lexvyshnevskyy/crsf-bridge/docs/tx12-16-contact_holder.SLDPRT

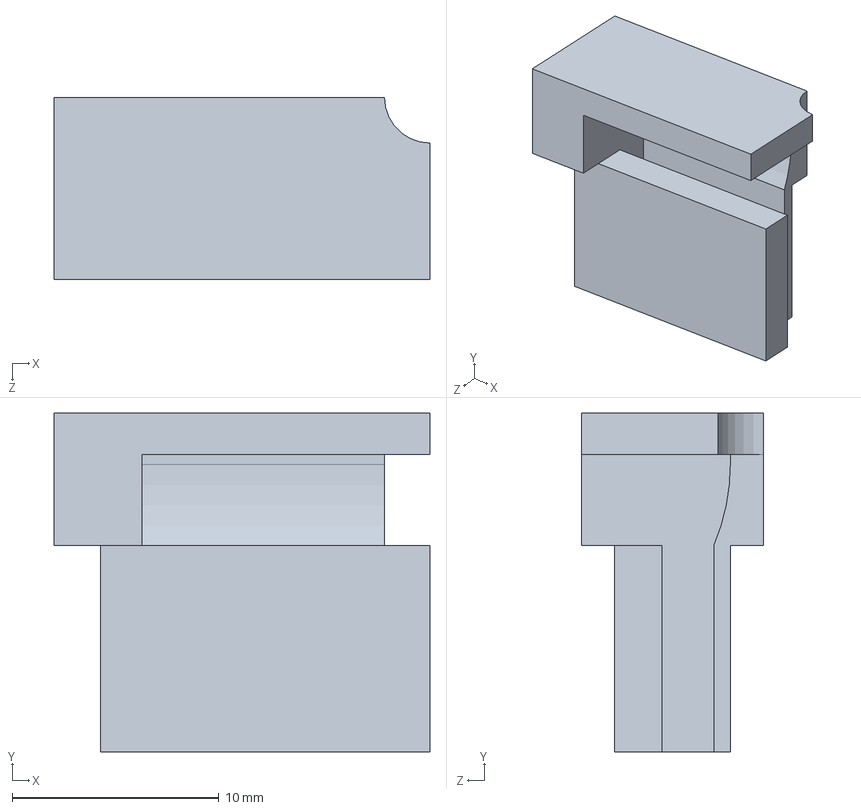
[picture p7: CAD file, 2026-11-03]
docs/tx12-16-contact_holder.SLDPRT
18.2 x 16.4 x 8.80 mm
