lexvyshnevskyy/crsf-bridge/docs/tx12-16_ethernet.SLDPRT

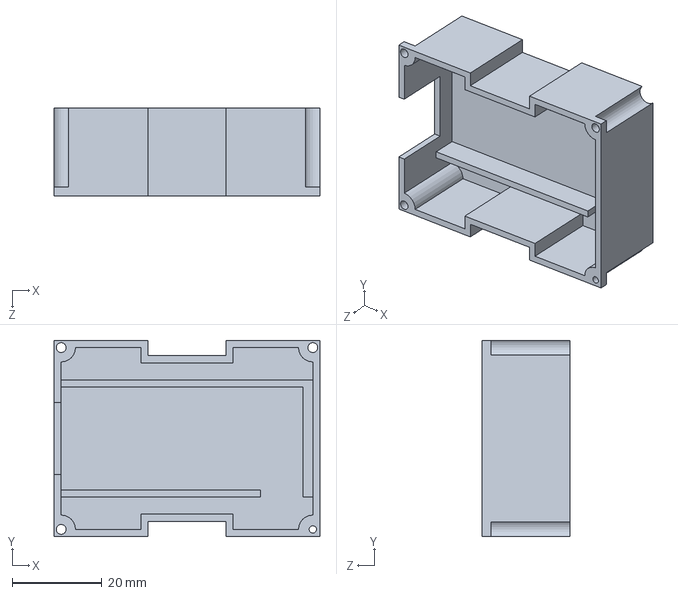
[picture p8: CAD file, 2026-11-03]
docs/tx12-16_ethernet.SLDPRT
59.4 x 43.8 x 19.6 mm
