lexvyshnevskyy/crsf-bridge/docs/tx12-16_module.SLDPRT

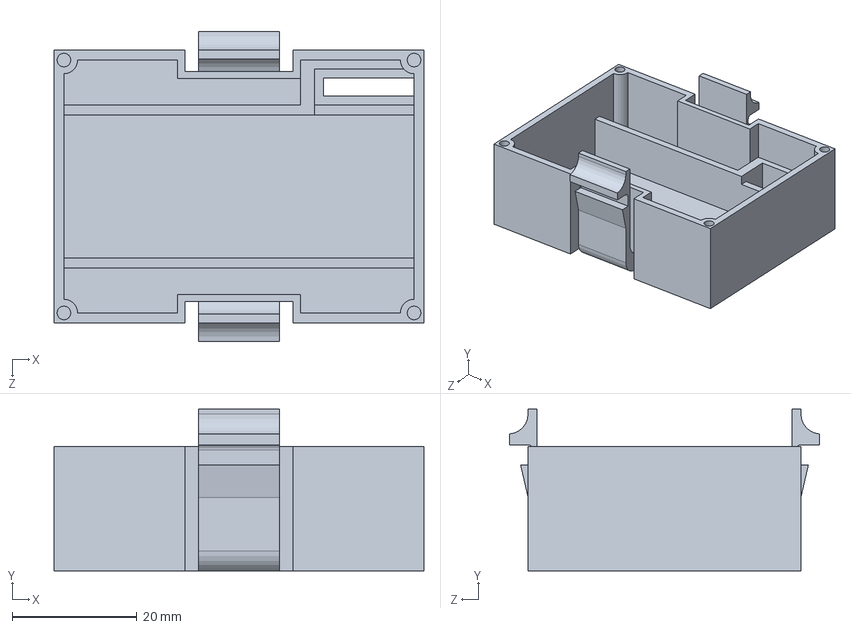
[picture p9: CAD file, 2026-11-03]
docs/tx12-16_module.SLDPRT
59.4 x 26.0 x 49.8 mm
