lexvyshnevskyy/crsf-bridge/(list of files, cad)

Other CAD files:
docs/tx12-16-contact_holder.STL
docs/tx12-16_ethernet.STL
docs/tx12-16_module.STL
